tregnier/egpad/Hardware/rev1_1/EGPad BOM.xlsx

Price | Part
6.85 | Microcontroller: Arduino Pro Micro (https://www.aliexpress.com/item/1005001621886380.html)
1.18 | M2 Screws 50pc 5mm (https://www.aliexpress.com/item/10000148429238.html)
2.93 | M2 Brass Standoff (https://www.aliexpress.com/item/1005001478740318.html)
1.05 | 0603 10nF Capacitors 100pc (https://www.aliexpress.com/item/32966526545.html)
2.84 | EC11 Rotary Encoder Knob + Cap 5pc (https://www.aliexpress.com/item/33030962017.html?spm=a2g0o.cart.0.0.62713c00U7fgrx&mp=1)
0.61 | 10kohm Resistor 100pc (https://www.aliexpress.com/item/10000056483250.html)
5.08 | 21 Key PBT Keycaps Blank White (https://www.aliexpress.com/item/1005001867842250.html)
113.46 | TS80P (https://www.aliexpress.com/item/32904980528.html)
32.31 | EGPad PCB 5pc (https://cart.jlcpcb.com/quote?orderType=1&stencilLayer=2)
Subtotal: | 166.31
Aliexpress total: | 154.76 (https://cdn.discordapp.com/attachments/703314060053184593/842948103278559232/unknown.png)
Estimated Total: | 198.62
Without TS80P: | 85.16
