tregnier/egpad/Hardware/Acrylic pin Top.stl

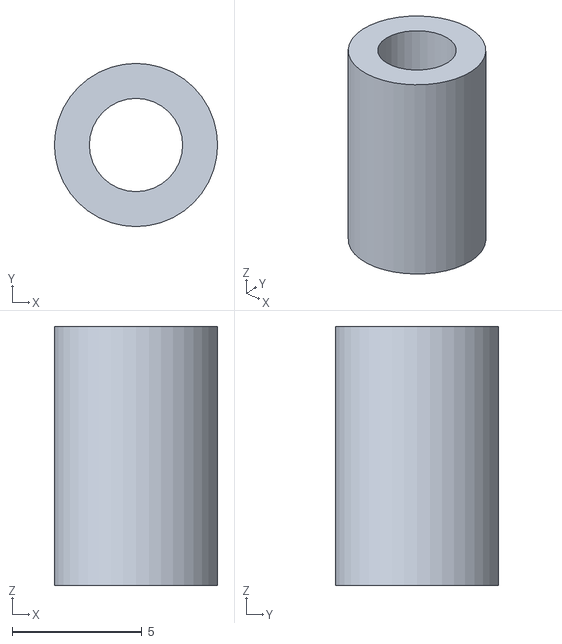
[picture p1: CAD file, 2022-01-27]
Hardware/Acrylic pin Top.stl
6.30 x 6.30 x 10.0
