tregnier/egpad/Hardware/Acrylic pin Bottom.stl

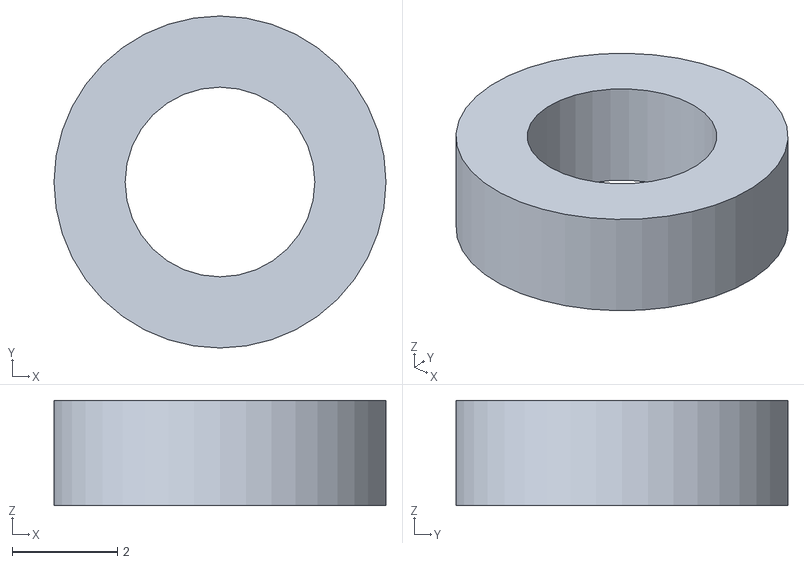
[picture p2: CAD file, 2022-01-27]
Hardware/Acrylic pin Bottom.stl
6.30 x 6.30 x 2.00
