tregnier/egpad/Hardware/Acrylic pin below keyboard.stl

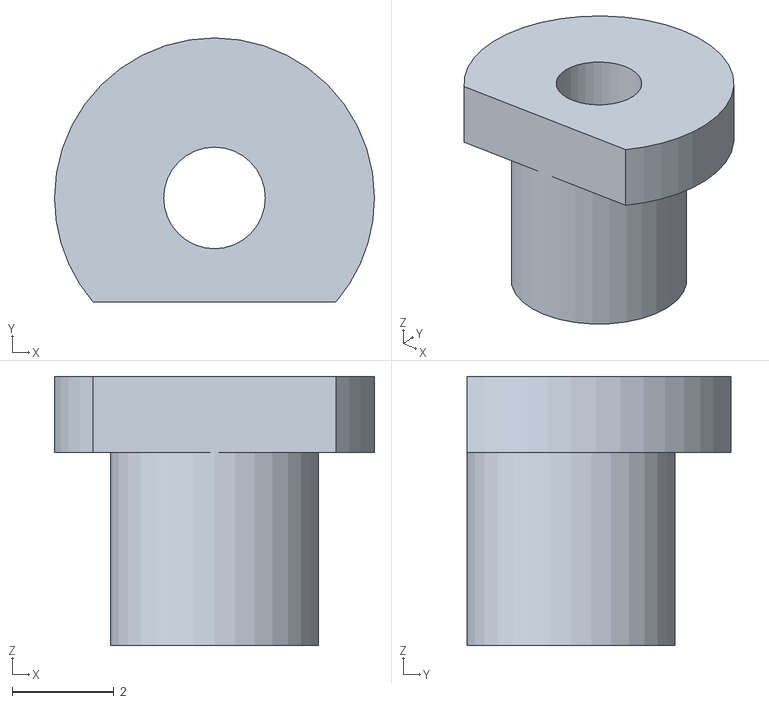
[picture p3: CAD file, 2022-01-27]
Hardware/Acrylic pin below keyboard.stl
6.30 x 5.20 x 5.30
