tregnier/egpad/Hardware/rev1/EGPad.step

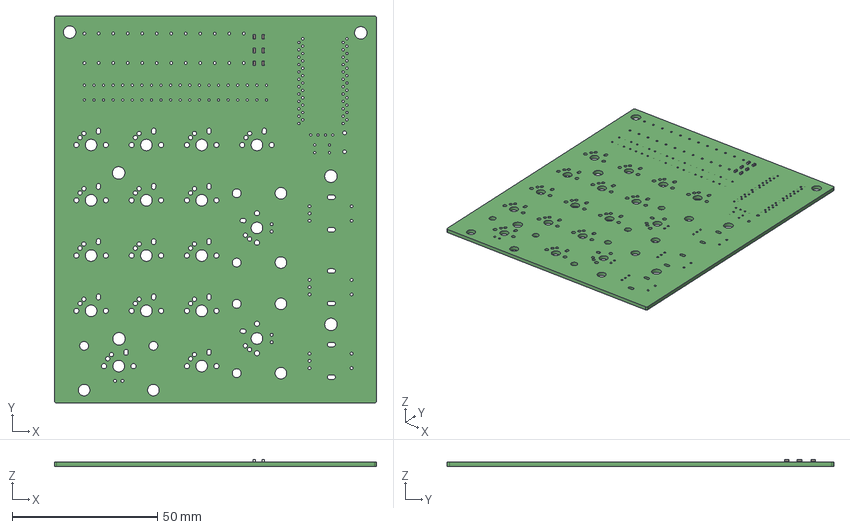
[picture p4: CAD file, 2022-01-27, an earlier design]
Hardware/rev1/EGPad.step
111.1 x 133.3 x 2.45 mm
