tregnier/egpad/Hardware/rev1/SVG/EGPad-Edge_Cuts.dxf

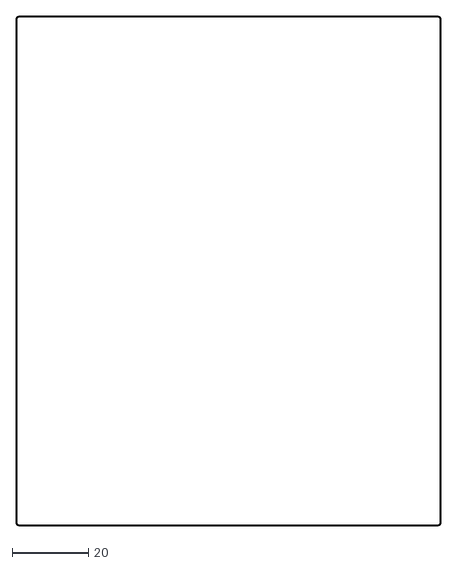
[picture p5: CAD file, 2022-01-27, an earlier design]
Hardware/rev1/SVG/EGPad-Edge_Cuts.dxf
111.2 x 133.4
