tregnier/egpad/Hardware/rev1/SVG/EGPad-Dwgs_User.dxf

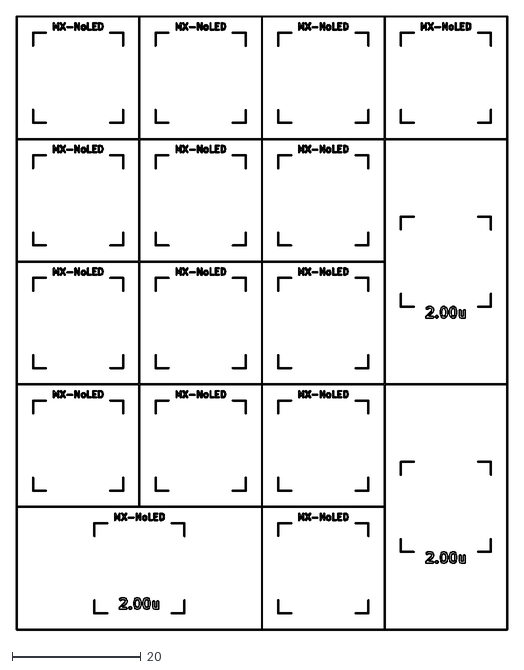
[picture p6: CAD file, 2022-01-27, an earlier design]
Hardware/rev1/SVG/EGPad-Dwgs_User.dxf
76.4 x 95.4
