tregnier/egpad/Hardware/rev1/SVG/top cover.dxf

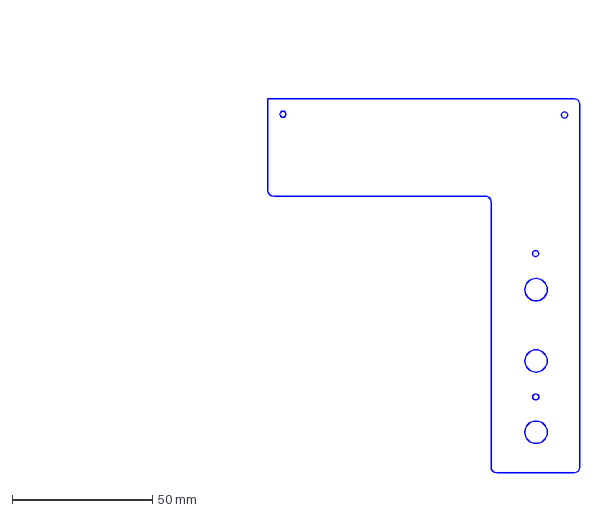
[picture p7: CAD file, 2022-01-27, an earlier design]
Hardware/rev1/SVG/top cover.dxf
200.8 x 162.7 mm
