tregnier/egpad/Hardware/rev1/SVG/bottom cover.dxf

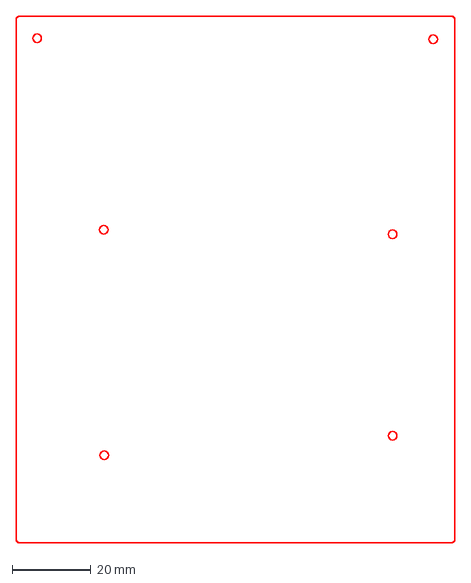
[picture p8: CAD file, 2022-01-27, an earlier design]
Hardware/rev1/SVG/bottom cover.dxf
111.2 x 133.4 mm
