tregnier/egpad/Hardware/rev1/SVG/EGPad-F_Fab.dxf

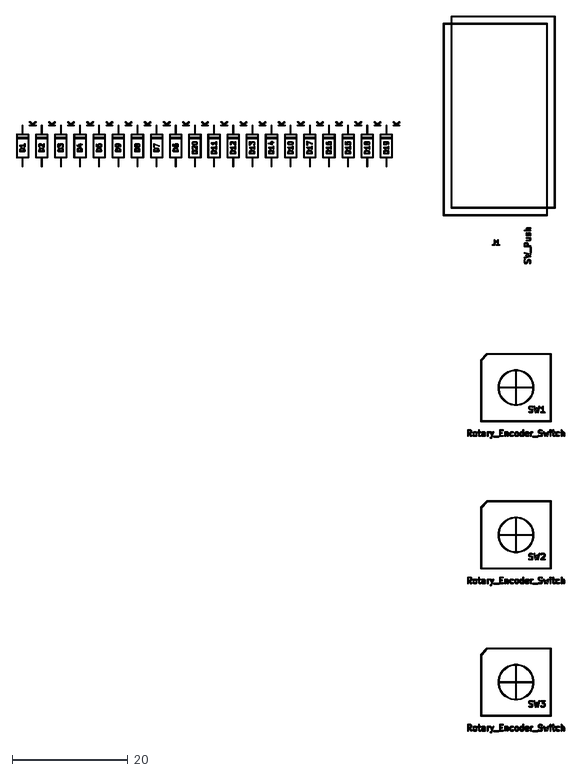
[picture p9: CAD file, 2022-01-27, an earlier design]
Hardware/rev1/SVG/EGPad-F_Fab.dxf
94.5 x 123.6
