tregnier/egpad/(list of files, cad)

Other CAD files:
Hardware/Acrylic pin Bottom.CATPart
Hardware/Acrylic pin Top.CATPart
Hardware/Acrylic pin below keyboard.CATPart
Hardware/rev1/SVG/EGPad-B_Mask.dxf
