tregnier/egpad/Hardware/rev1/EGPad.kicad_pcb

## KiCad design Hardware/rev1/EGPad.kicad_pcb (2021-11-10, an earlier design)

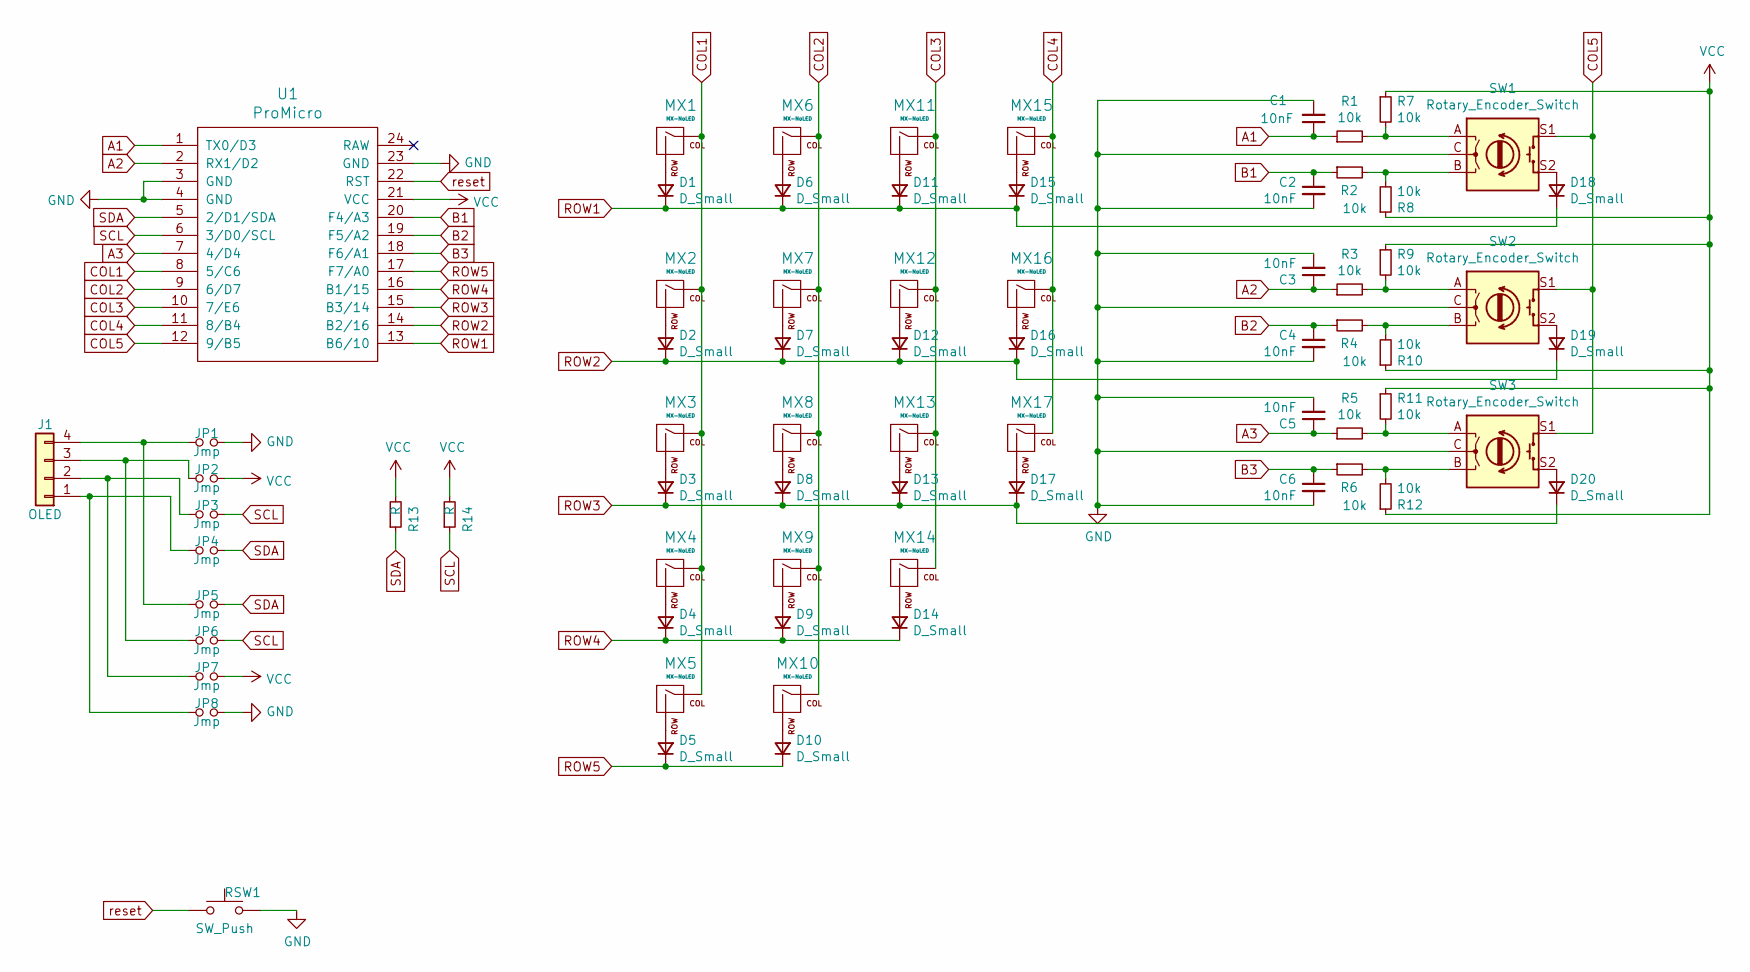
[picture p10: schematic EGPad.sch]

Parts:
C1, C2, C3, C4, C5, C6: 10nF; C_0603
D1, D2, D3, D4, D5, D6, D7, D8, D9, D10, D11, D12, D13, D14, D15, D16, D17, D18, D19, D20: D_Small; MD_Diode
J1: OLED
JP1, JP2, JP3, JP4, JP5, JP6, JP7, JP8: Jmp; Jumper
MX1, MX2, MX3, MX4, MX6, MX7, MX8, MX9, MX10, MX12, MX13, MX14, MX15: MX-NoLED; MX-1U-NoLED
MX5: MX-NoLED; MX-2U-NoLED
MX11: MX-NoLED; MXOnly-1U-NoLED
MX16, MX17: MX-NoLED; Hybrid_PCB_200V
R1, R2, R3, R4, R5, R6, R7, R8, R9, R10, R11, R12: 10k; Resistor
R13, R14: R
RSW1: SW_Push; ResetSW
SW1, SW2, SW3: Rotary_Encoder_Switch; RotaryEncoder_EC11
U1: ProMicro; ProMicro_v2

Connections:
A1: C1.1, R1.1, U1.1 (TX0/D3)
A2: C3.1, R3.1, U1.2 (RX1/D2)
A3: C5.1, R5.1, U1.7 (4/D4)
B1: C2.1, R2.1, U1.20 (F4/A3)
B2: C4.1, R4.1, U1.19 (F5/A2)
B3: C6.1, R6.1, U1.18 (F6/A1)
COL1: MX1.1 (COL), MX2.1 (COL), MX3.1 (COL), MX4.1 (COL), MX5.1 (COL), U1.8 (5/C6)
COL2: MX6.1 (COL), MX7.1 (COL), MX8.1 (COL), MX9.1 (COL), MX10.1 (COL), U1.9 (6/D7)
COL3: MX11.1 (COL), MX12.1 (COL), MX13.1 (COL), MX14.1 (COL), U1.10 (7/E6)
COL4: MX15.1 (COL), MX16.1 (COL), MX17.1 (COL), U1.11 (8/B4)
COL5: SW1.S1, SW2.S1, SW3.S1, U1.12 (9/B5)
GND: C1.2, C2.2, C3.2, C4.2, C5.2, C6.2, JP1.2, JP8.2, RSW1.2, SW1.C, SW2.C, SW3.C, U1.3 (GND), U1.4 (GND), U1.23 (GND)
unnamed: D1.2 (A), MX1.2 (ROW)
unnamed: D2.2 (A), MX2.2 (ROW)
unnamed: D3.2 (A), MX3.2 (ROW)
unnamed: D4.2 (A), MX4.2 (ROW)
unnamed: D5.2 (A), MX5.2 (ROW)
unnamed: D6.2 (A), MX6.2 (ROW)
unnamed: D7.2 (A), MX7.2 (ROW)
unnamed: D8.2 (A), MX8.2 (ROW)
unnamed: D9.2 (A), MX9.2 (ROW)
unnamed: D10.2 (A), MX10.2 (ROW)
unnamed: D11.2 (A), MX11.2 (ROW)
unnamed: D12.2 (A), MX12.2 (ROW)
unnamed: D13.2 (A), MX13.2 (ROW)
unnamed: D14.2 (A), MX14.2 (ROW)
unnamed: D15.2 (A), MX15.2 (ROW)
unnamed: D16.2 (A), MX16.2 (ROW)
unnamed: D17.2 (A), MX17.2 (ROW)
unnamed: D18.2 (A), SW1.S2
unnamed: D19.2 (A), SW2.S2
unnamed: D20.2 (A), SW3.S2
unnamed: J1.1, JP4.1, JP8.1
unnamed: J1.2, JP3.1, JP7.1
unnamed: J1.3, JP2.1, JP6.1
unnamed: J1.4, JP1.1, JP5.1
unnamed: R1.2, R7.2, SW1.A
unnamed: R2.2, R8.2, SW1.B
unnamed: R3.2, R9.2, SW2.A
unnamed: R4.2, R10.2, SW2.B
unnamed: R5.2, R11.2, SW3.A
unnamed: R6.2, R12.2, SW3.B
ROW1: D1.1 (K), D6.1 (K), D11.1 (K), D15.1 (K), D18.1 (K), U1.13 (B6/10)
ROW2: D2.1 (K), D7.1 (K), D12.1 (K), D16.1 (K), D19.1 (K), U1.14 (B2/16)
ROW3: D3.1 (K), D8.1 (K), D13.1 (K), D17.1 (K), D20.1 (K), U1.15 (B3/14)
ROW4: D4.1 (K), D9.1 (K), D14.1 (K), U1.16 (B1/15)
ROW5: D5.1 (K), D10.1 (K), U1.17 (F7/A0)
SCL: JP3.2, JP6.2, R14.1, U1.6 (3/D0/SCL)
SDA: JP4.2, JP5.2, R13.1, U1.5 (2/D1/SDA)
VCC: JP2.2, JP7.2, R7.1, R8.1, R9.1, R10.1, R11.1, R12.1, R13.2, R14.2, U1.21 (VCC)
reset: RSW1.1, U1.22 (RST)

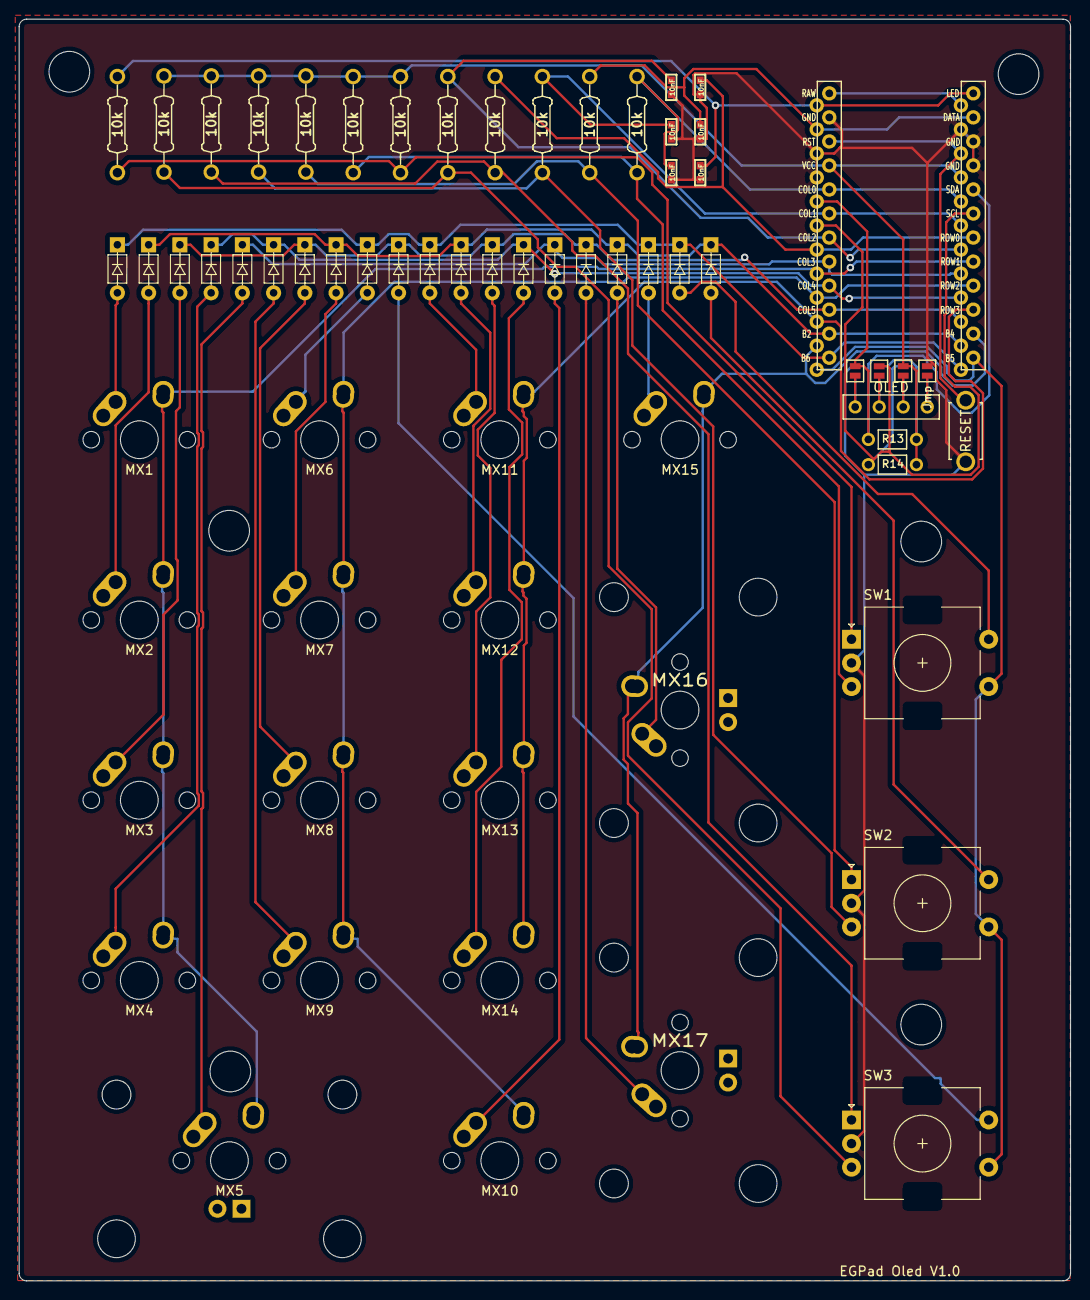
[picture p11: board EGPad.kicad_pcb from above]

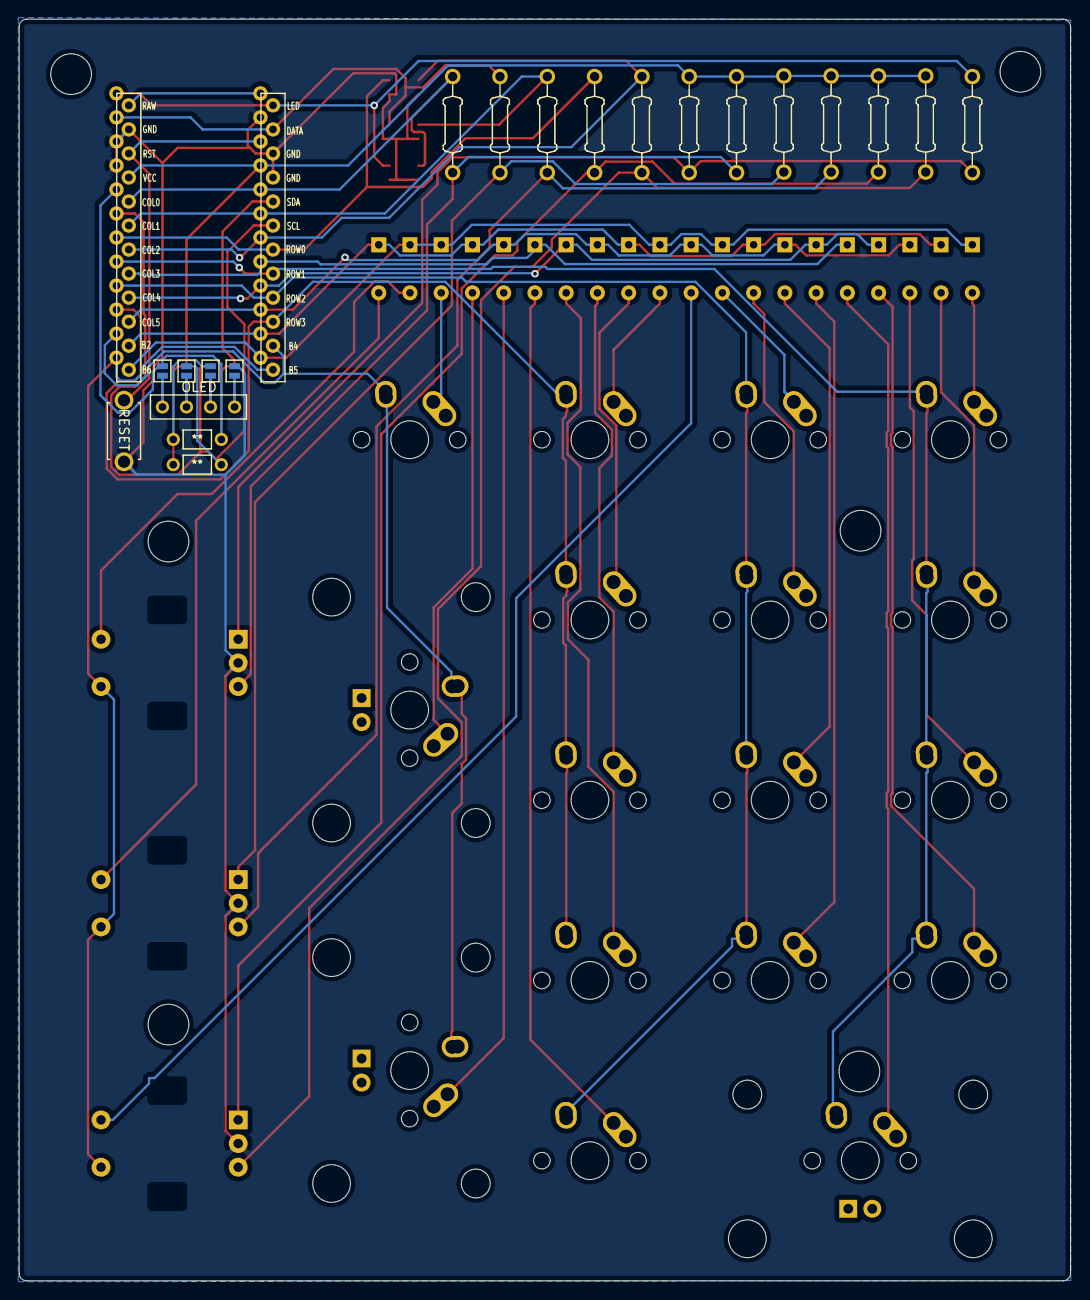
[picture p12: board EGPad.kicad_pcb from below]

Board: 2 copper layers, 111.1 x 133.3 mm, 77 parts (4 on the bottom side), 51 nets.

Other parts of the board:
Ref**, Ref**1, Ref**2, Ref**4, Ref**5, Ref**6: Val**; M2_HOLE_v2
