tregnier/egpad/(commit log)

2021-10-29 adding oled from Corne style and reverse PCB
    [EGPad-B_Cu.gbl, EGPad-B_Mask.gbs, EGPad-B_Paste.gbp, EGPad-B_SilkS.gbo, EGPad-Edge_Cuts.gm1, EGPad-F_Cu.gtl, EGPad-F_Mask.gts, EGPad-F_Paste.gtp]
2021-10-30 optimization and gerber for production
    [EGPad-B_Cu.gbl, EGPad-B_Mask.gbs, EGPad-B_Paste.gbp, EGPad-B_SilkS.gbo, EGPad-Edge_Cuts.gm1, EGPad-F_Cu.gtl, EGPad-F_Mask.gts, EGPad-F_Paste.gtp]
2021-11-10 egpad oled gerber file v1.0
2021-11-10 clean up
    [EGPad BOM.xlsx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]
2021-11-10 adding rev 1_1 for sapping face on switch too
    [EGPad BOM.xlsx, EGPad.kicad_pcb, EGPad.sch]
2021-11-26 add acrylic cover
    [EGPad-B_Mask.dxf, EGPad-Dwgs_User.dxf, EGPad-Edge_Cuts.dxf, EGPad-F_Fab.dxf, bottom cover.dxf, top cover.dxf]
2022-01-27 adding spacer to hardware
    [Acrylic pin Bottom.CATPart, Acrylic pin Bottom.stl, Acrylic pin Top.CATPart, Acrylic pin Top.stl, Acrylic pin below keyboard.CATPart, Acrylic pin below keyboard.stl, EGPad.step]
